stardestro/MechaMocha_ERBIE/serviceDiagram.png

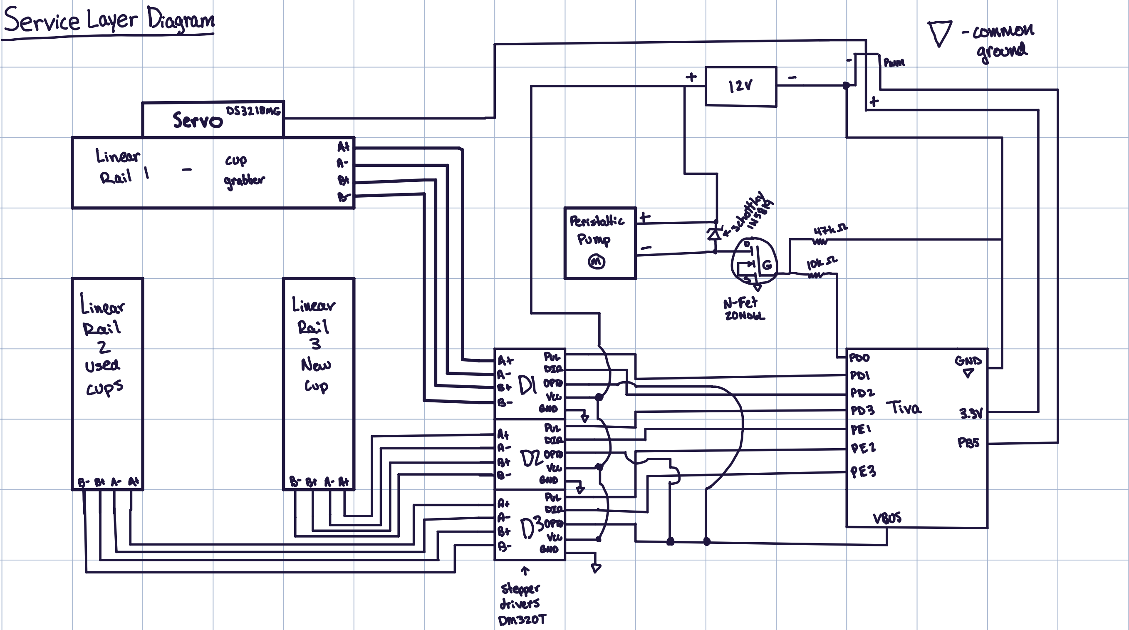
serviceDiagram.png
