stardestro/MechaMocha_ERBIE/3D Files/1802-0043-0001 assembly.stl

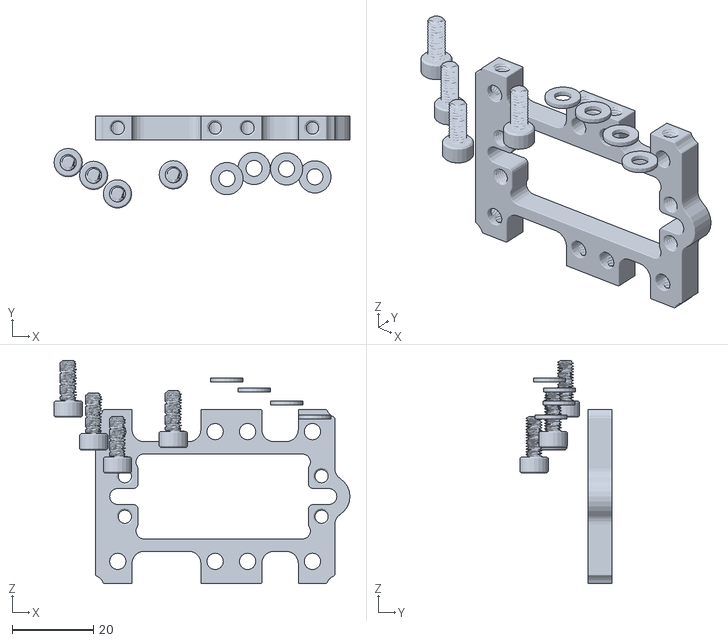
[picture p19: CAD file, 2024-05-01]
3D Files/1802-0043-0001 assembly.stl
73.0 x 22.7 x 55.1
