stardestro/MechaMocha_ERBIE/3D Files/SPOUT.stl

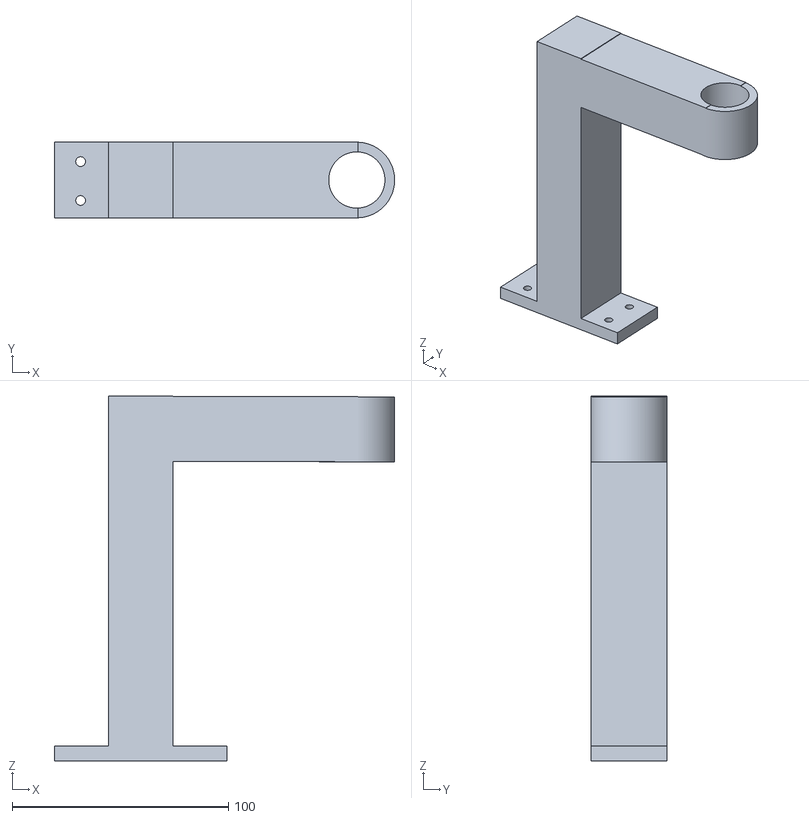
[picture p20: CAD file, 2024-05-01]
3D Files/SPOUT.stl
157.5 x 35.0 x 168.9
