stardestro/MechaMocha_ERBIE/3D Files/GearTest.stl

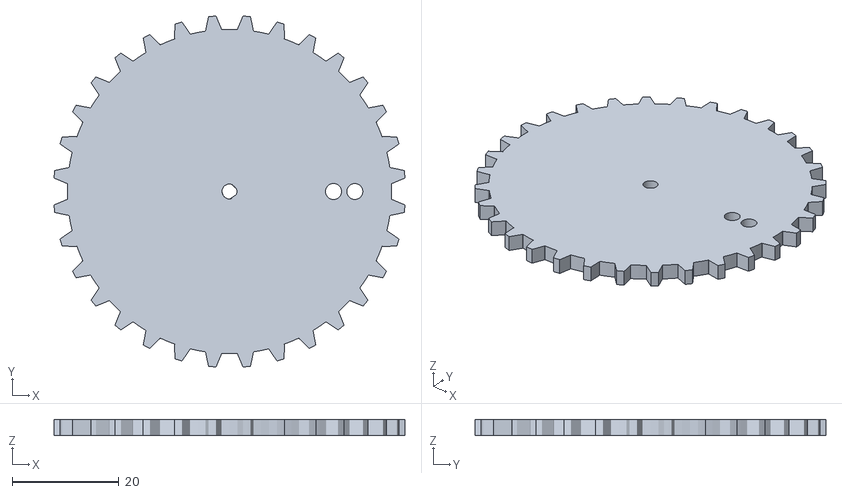
[picture p21: CAD file, 2024-05-01]
3D Files/GearTest.stl
65.8 x 65.8 x 3.00
