stardestro/MechaMocha_ERBIE/3D Files/SplineTest.stl

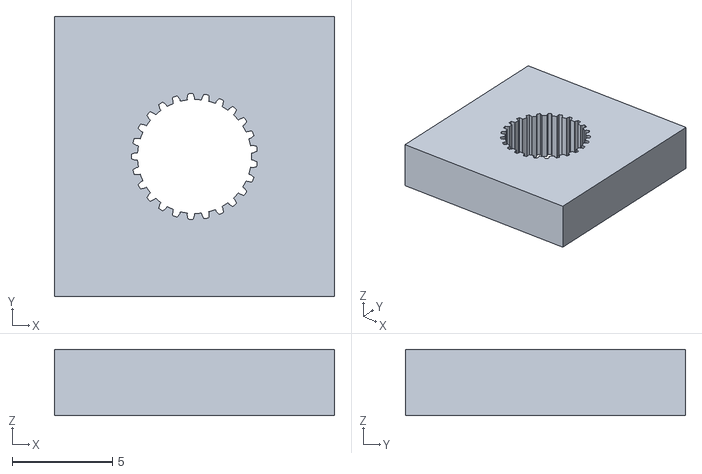
[picture p22: CAD file, 2024-05-01]
3D Files/SplineTest.stl
14.0 x 14.0 x 3.31
