stardestro/MechaMocha_ERBIE/3D Files/mountingplate.stl

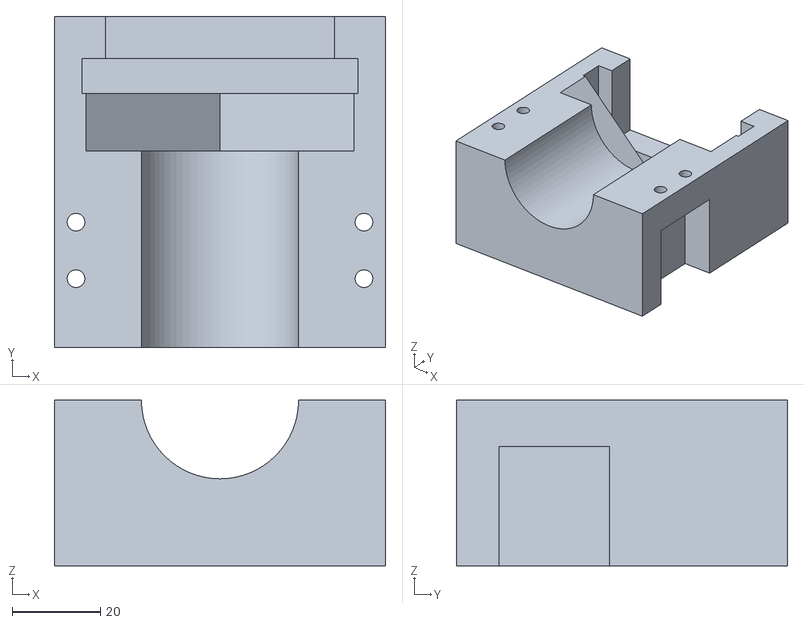
[picture p23: CAD file, 2024-05-01]
3D Files/mountingplate.stl
75.0 x 75.0 x 37.5
