stardestro/MechaMocha_ERBIE/3D Files/GrabberWithLimitSwitchV2.stl

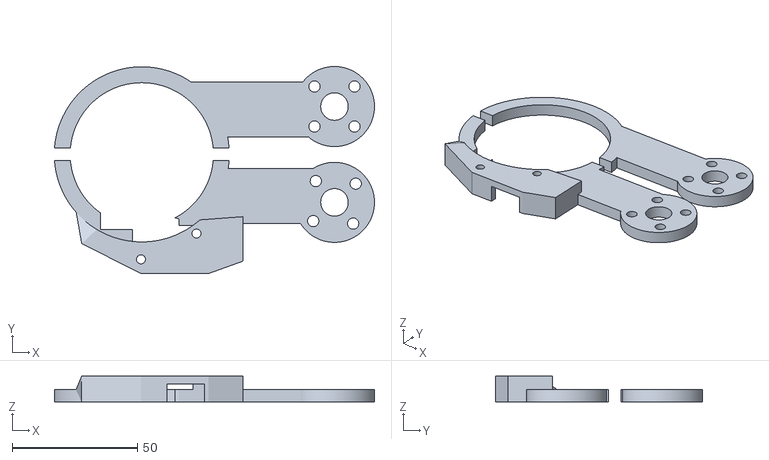
[picture p24: CAD file, 2024-05-01]
3D Files/GrabberWithLimitSwitchV2.stl
127.9 x 82.7 x 10.3
