stardestro/MechaMocha_ERBIE/3D Files/jetsonHolder.stl

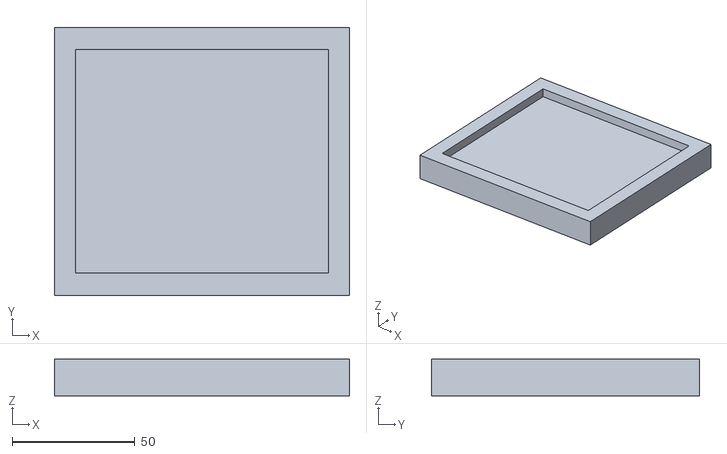
[picture p25: CAD file, 2024-05-01]
3D Files/jetsonHolder.stl
120.0 x 108.9 x 15.0
