stardestro/MechaMocha_ERBIE/3D Files/CoffeeGrabberHolderV2.stl

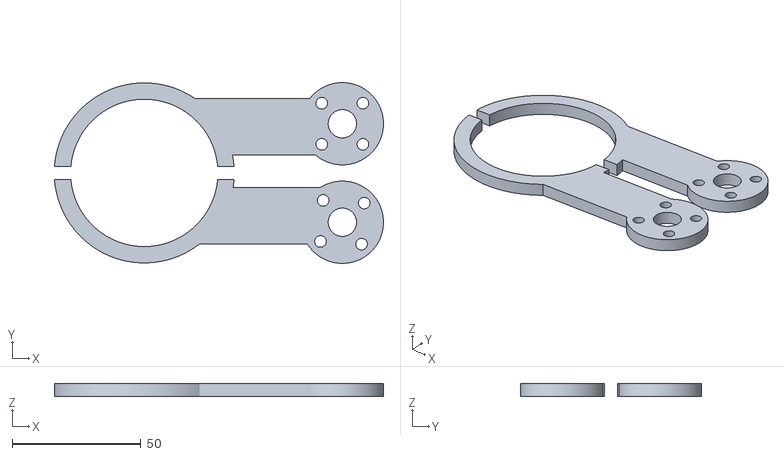
[picture p26: CAD file, 2024-05-01]
3D Files/CoffeeGrabberHolderV2.stl
127.9 x 70.3 x 5.00
