stardestro/MechaMocha_ERBIE/3D Files/SPOUTV2.stl

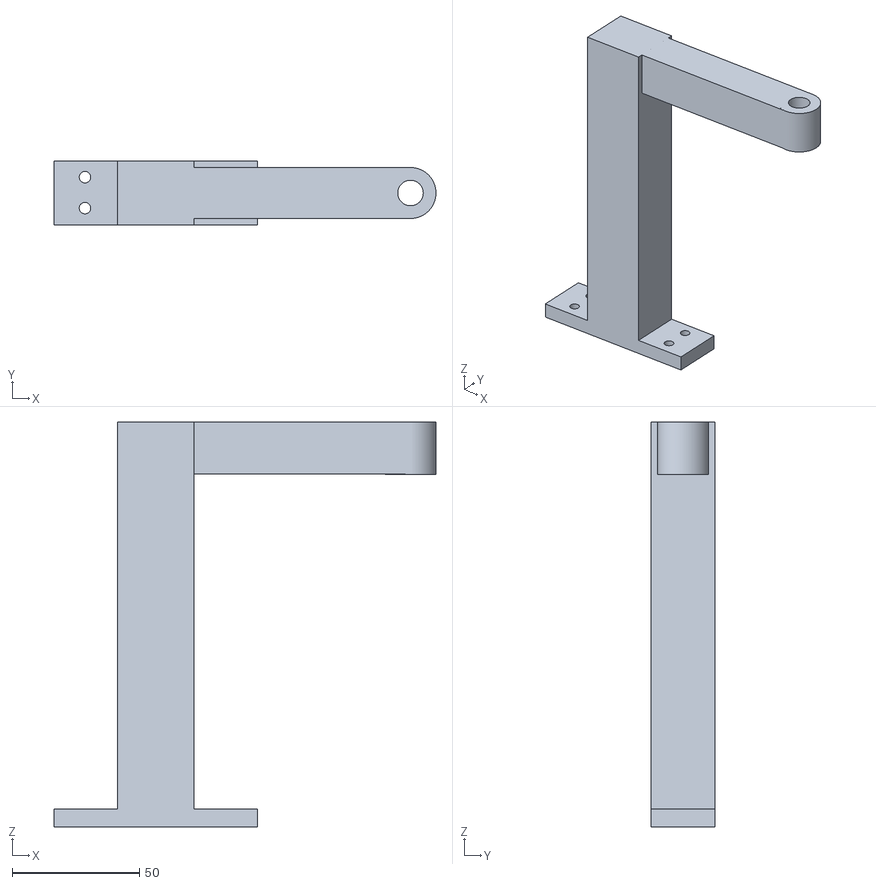
[picture p27: CAD file, 2024-05-01]
3D Files/SPOUTV2.stl
150.0 x 25.0 x 159.0
