stardestro/MechaMocha_ERBIE/3D Files/GuideRailV2.stl

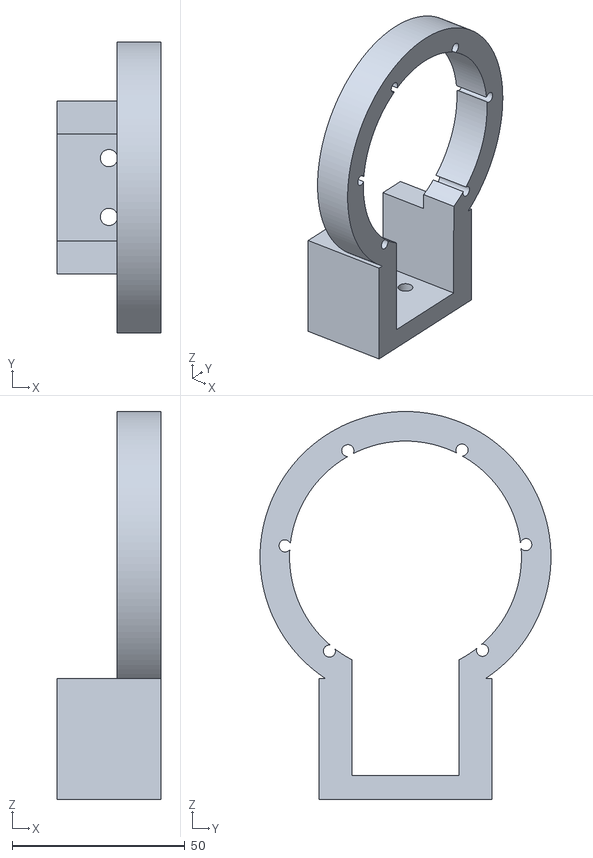
[picture p28: CAD file, 2024-05-01]
3D Files/GuideRailV2.stl
30.0 x 84.1 x 112.2
