stardestro/MechaMocha_ERBIE/3D Files/CoffeeGrabberSupportV3stl.stl

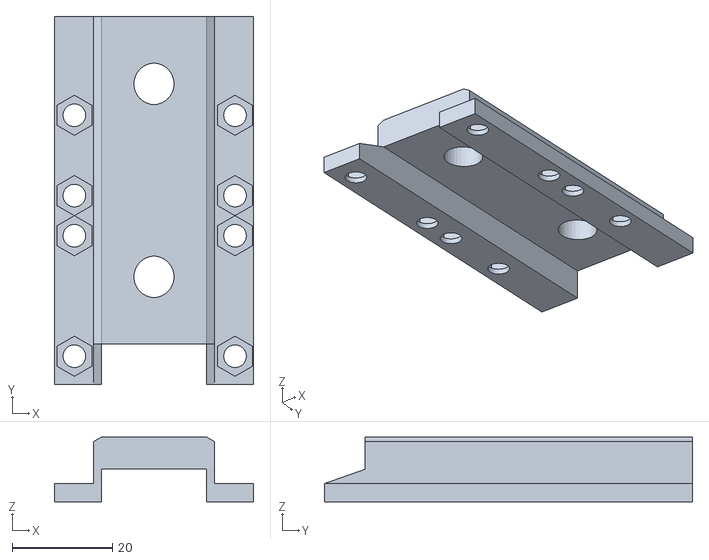
[picture p29: CAD file, 2024-05-01]
3D Files/CoffeeGrabberSupportV3stl.stl
39.7 x 73.3 x 12.9
