stardestro/MechaMocha_ERBIE/3D Files/StackHolder.stl

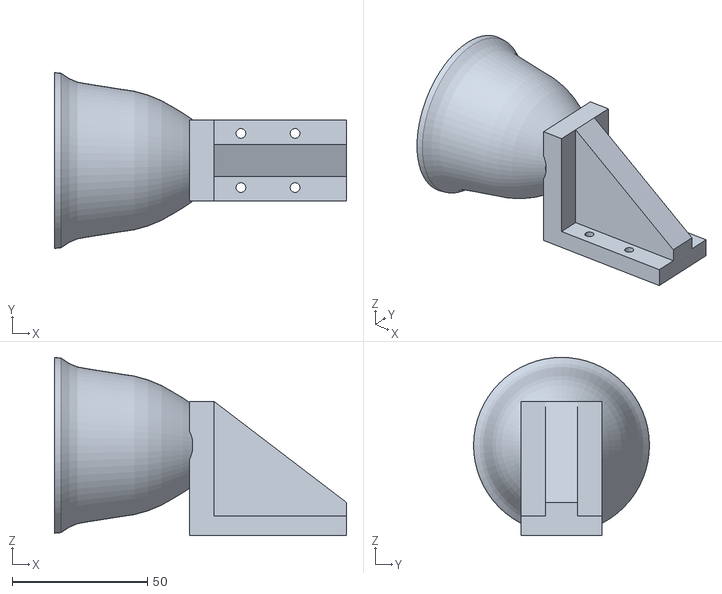
[picture p30: CAD file, 2024-05-01]
3D Files/StackHolder.stl
107.9 x 65.0 x 65.9
