stardestro/MechaMocha_ERBIE/3D Files/CupSizeExperimentV3.stl

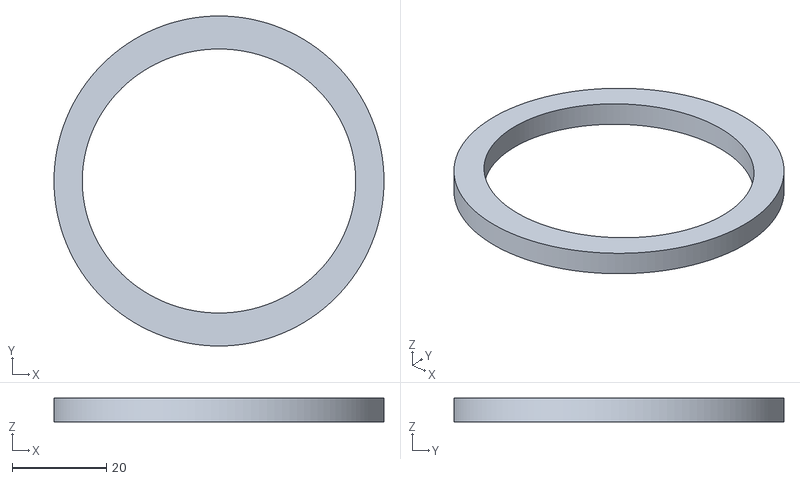
[picture p31: CAD file, 2024-05-01]
3D Files/CupSizeExperimentV3.stl
70.0 x 70.0 x 5.00
