stardestro/MechaMocha_ERBIE/3D Files/coffeearm.stl

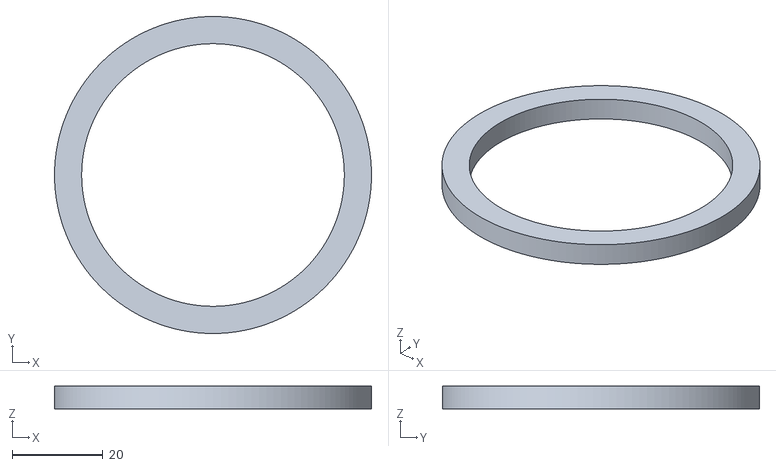
[picture p32: CAD file, 2024-05-01]
3D Files/coffeearm.stl
70.0 x 70.0 x 5.00
