stardestro/MechaMocha_ERBIE/3D Files/OverFlow.stl

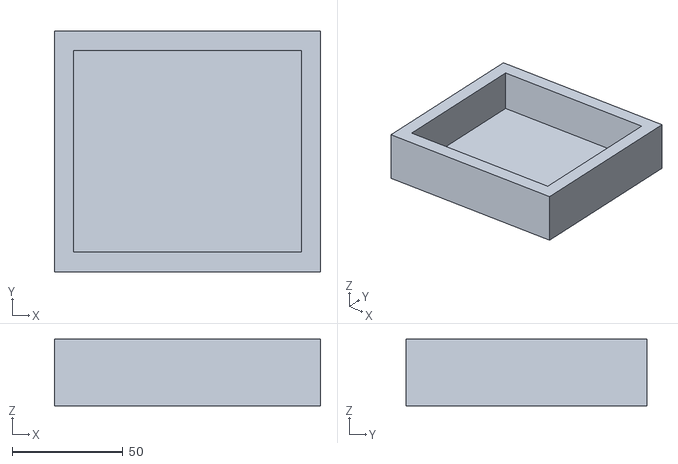
[picture p33: CAD file, 2024-05-01]
3D Files/OverFlow.stl
120.0 x 108.9 x 30.0
