stardestro/MechaMocha_ERBIE/3D Files/1910-0025-0816.stl

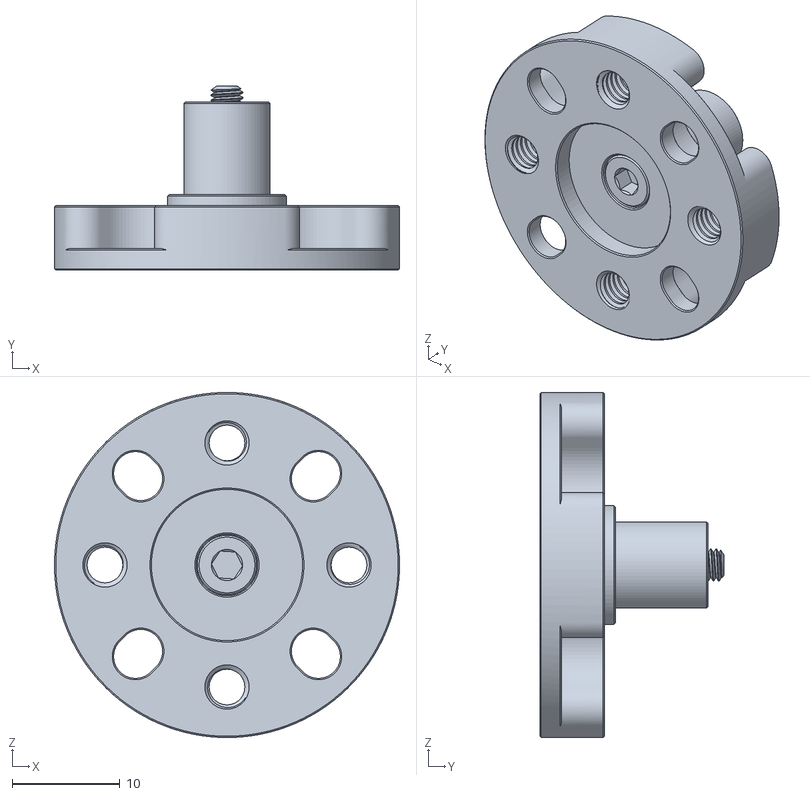
[picture p34: CAD file, 2024-05-01]
3D Files/1910-0025-0816.stl
32.0 x 17.1 x 32.0
