stardestro/MechaMocha_ERBIE/3D Files/faceplate.stl

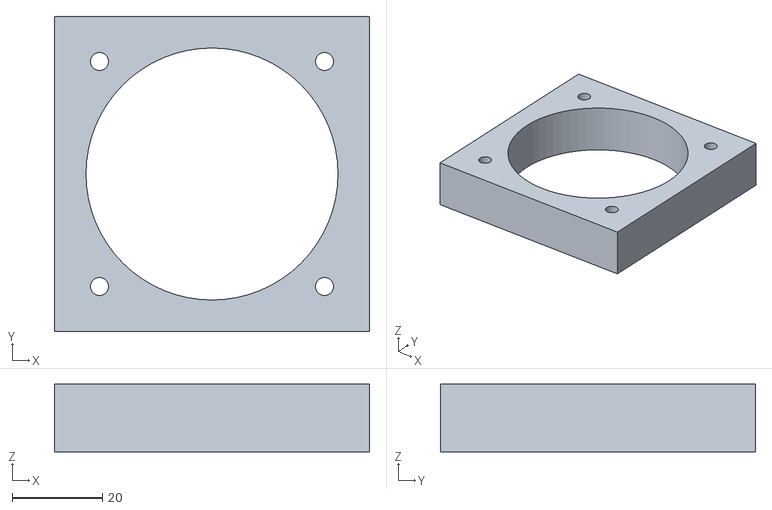
[picture p35: CAD file, 2024-05-01]
3D Files/faceplate.stl
70.0 x 70.0 x 15.0
