stardestro/MechaMocha_ERBIE/3D Files/1910-0024-1033.stl

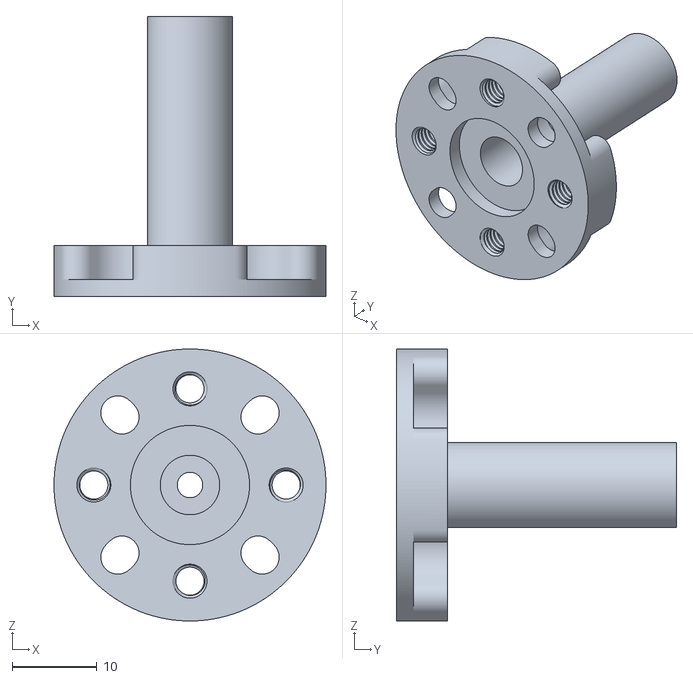
[picture p36: CAD file, 2024-05-01]
3D Files/1910-0024-1033.stl
32.0 x 33.0 x 32.0
