stardestro/MechaMocha_ERBIE/3D Files/mountingplateV2.stl

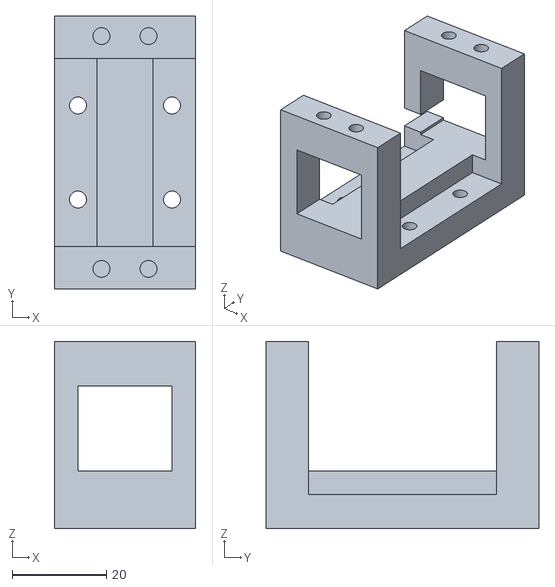
[picture p37: CAD file, 2024-05-01]
3D Files/mountingplateV2.stl
30.0 x 58.0 x 39.8
