stardestro/MechaMocha_ERBIE/3D Files/PumpholderV3.stl

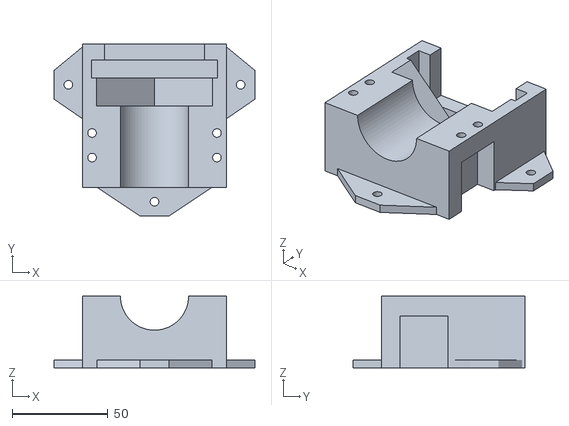
[picture p38: CAD file, 2024-05-01]
3D Files/PumpholderV3.stl
105.0 x 90.0 x 37.5
