stardestro/MechaMocha_ERBIE/3D Files/realsenseholder.stl

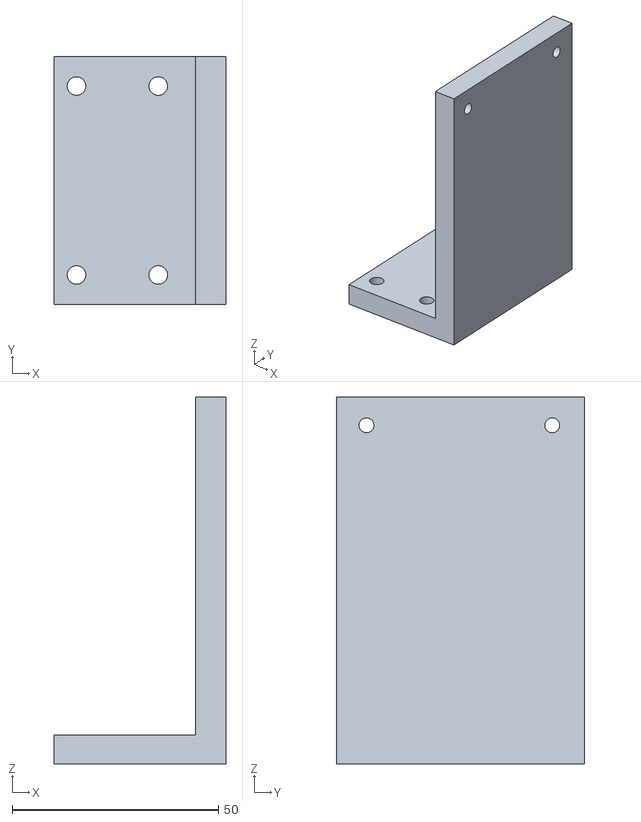
[picture p39: CAD file, 2024-05-01]
3D Files/realsenseholder.stl
41.6 x 60.0 x 88.9
