stardestro/MechaMocha_ERBIE/3D Files/GrabberWithLimitSwitch.stl

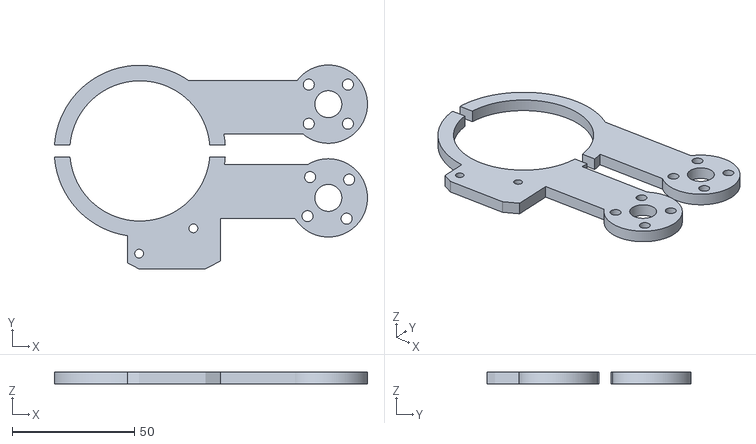
[picture p40: CAD file, 2024-05-01]
3D Files/GrabberWithLimitSwitch.stl
127.9 x 83.4 x 5.00
