stardestro/MechaMocha_ERBIE/3D Files/realsensetest.stl

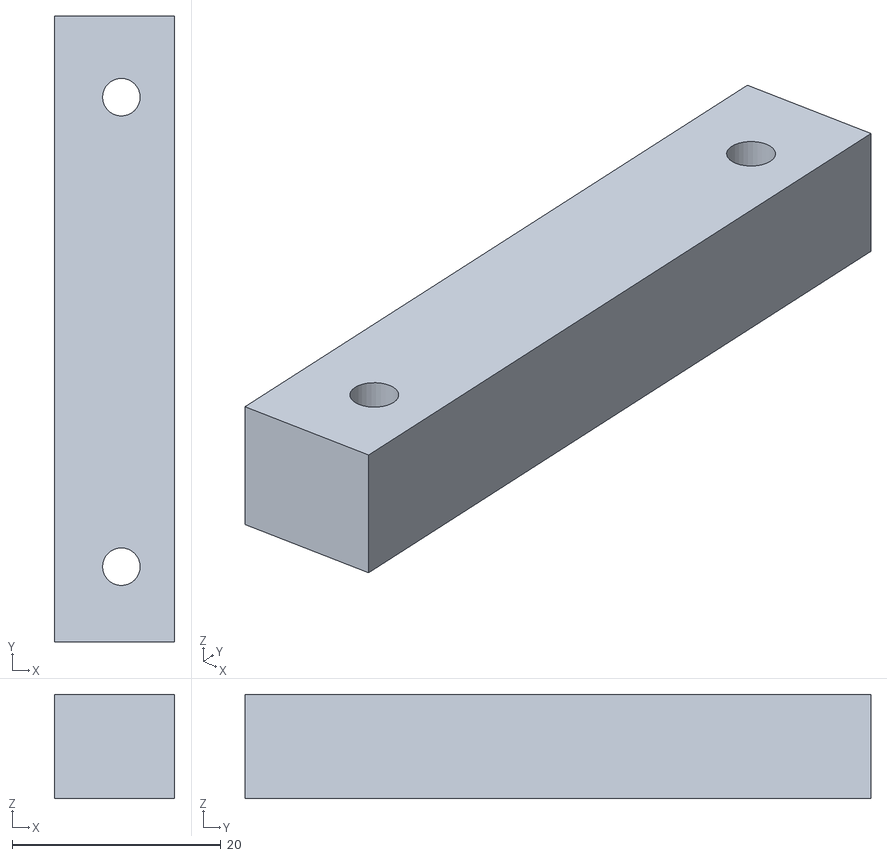
[picture p41: CAD file, 2024-05-01]
3D Files/realsensetest.stl
11.5 x 60.0 x 10.0
