stardestro/MechaMocha_ERBIE/3D Files/qahwacupwithhole.stl

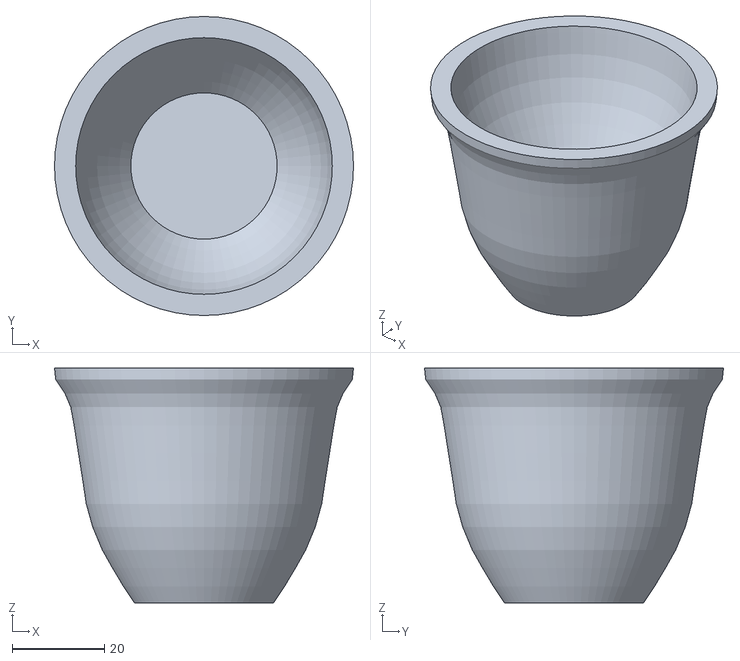
[picture p43: CAD file, 2024-05-01]
3D Files/qahwacupwithhole.stl
65.0 x 65.0 x 51.0
