stardestro/MechaMocha_ERBIE/3D Files/2302-0014-0048.stl

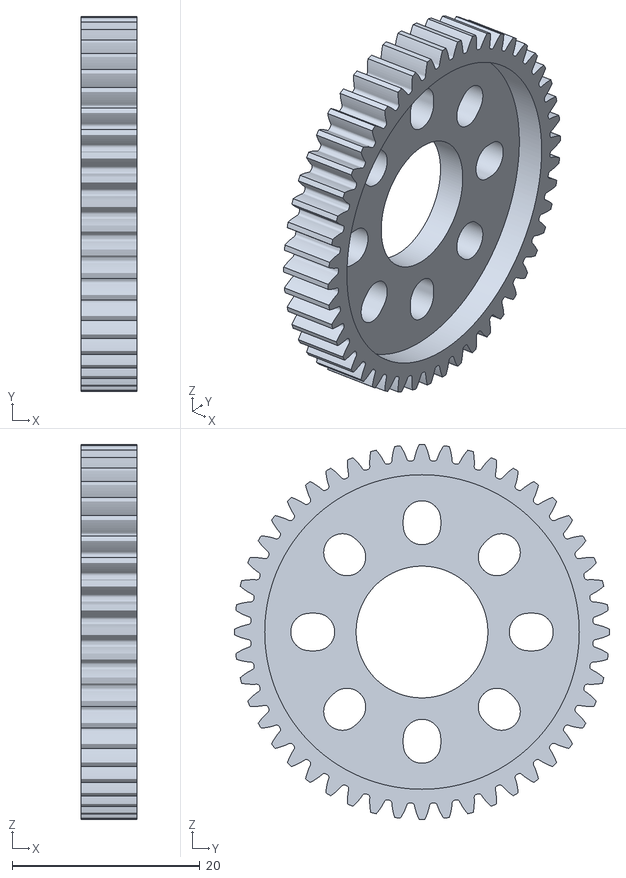
[picture p44: CAD file, 2024-05-01]
3D Files/2302-0014-0048.stl
6.00 x 40.0 x 40.0
