stardestro/MechaMocha_ERBIE/3D Files/PumpholderH2.stl

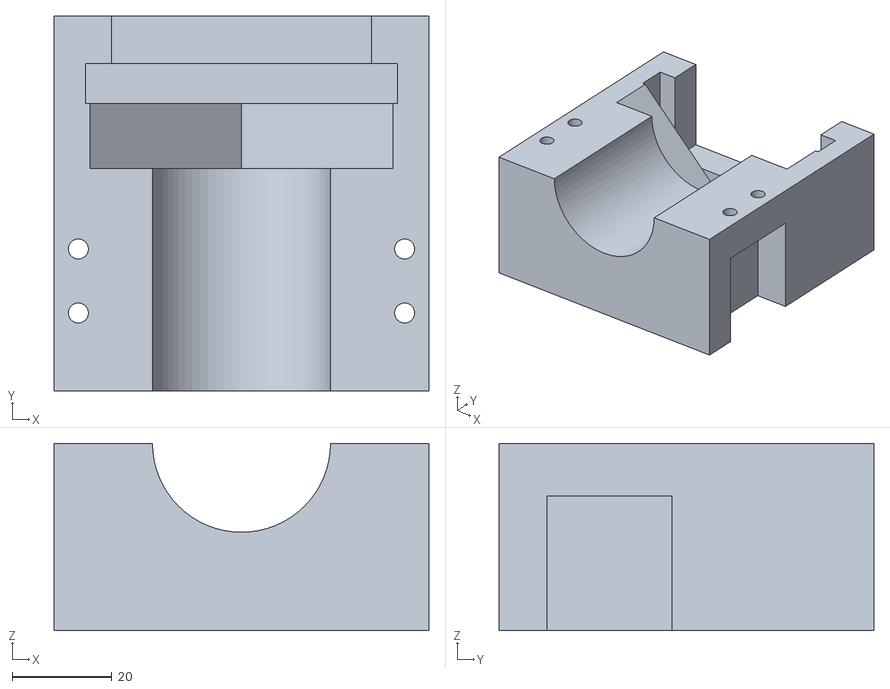
[picture p45: CAD file, 2024-05-01]
3D Files/PumpholderH2.stl
75.0 x 75.0 x 37.5
