stardestro/MechaMocha_ERBIE/3D Files/CupholderV2.stl

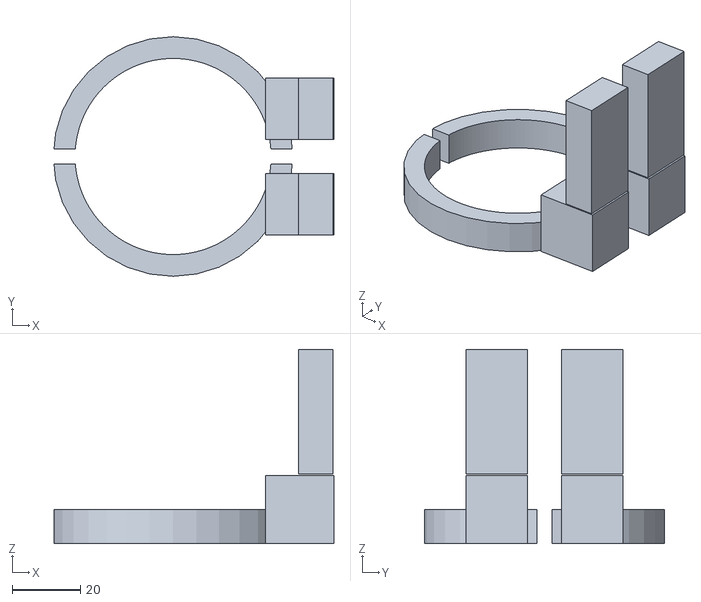
[picture p46: CAD file, 2024-05-01]
3D Files/CupholderV2.stl
81.8 x 70.0 x 56.8
