stardestro/MechaMocha_ERBIE/3D Files/stackerbase.stl

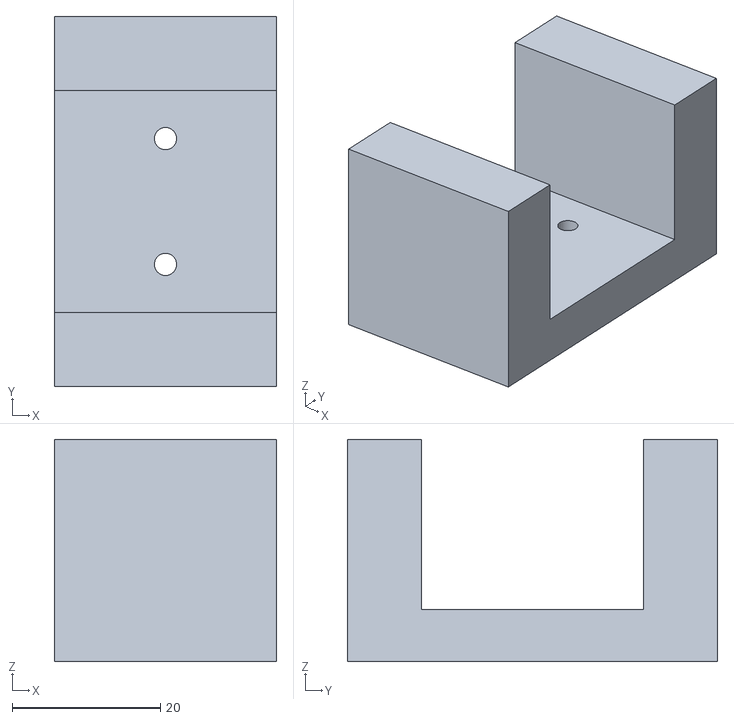
[picture p47: CAD file, 2024-05-01]
3D Files/stackerbase.stl
30.0 x 50.0 x 30.0
