stardestro/MechaMocha_ERBIE/3D Files/baseconnectorV2stl.stl

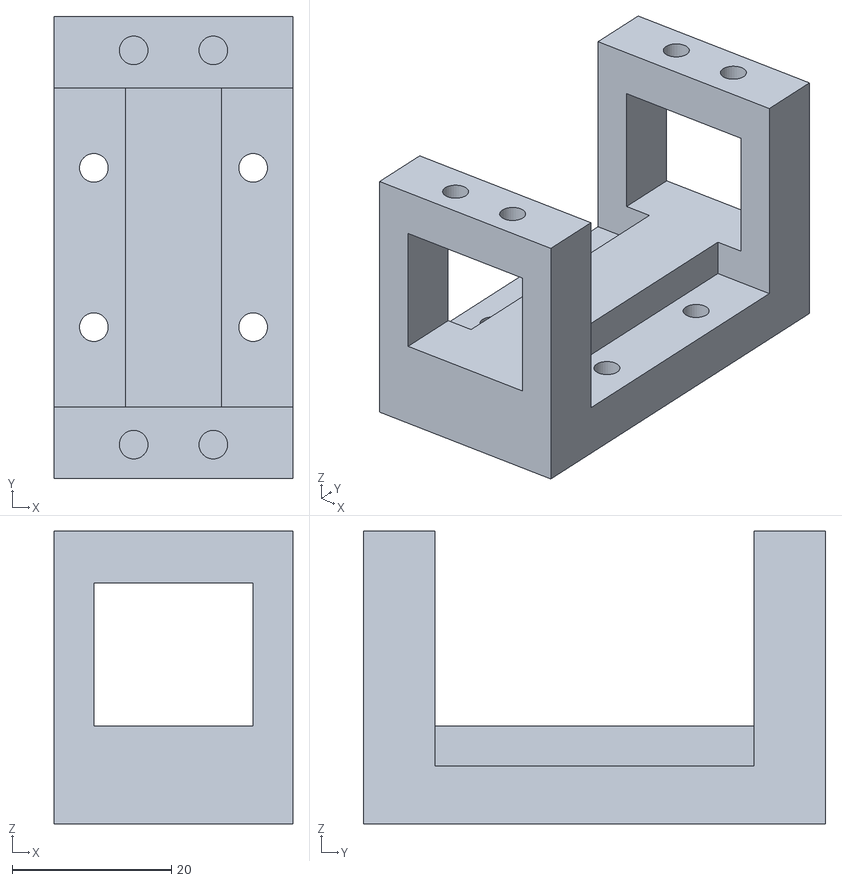
[picture p48: CAD file, 2024-05-01]
3D Files/baseconnectorV2stl.stl
30.0 x 58.0 x 36.8
