stardestro/MechaMocha_ERBIE/3D Files/CoffeeGrabberSupportV5.stl

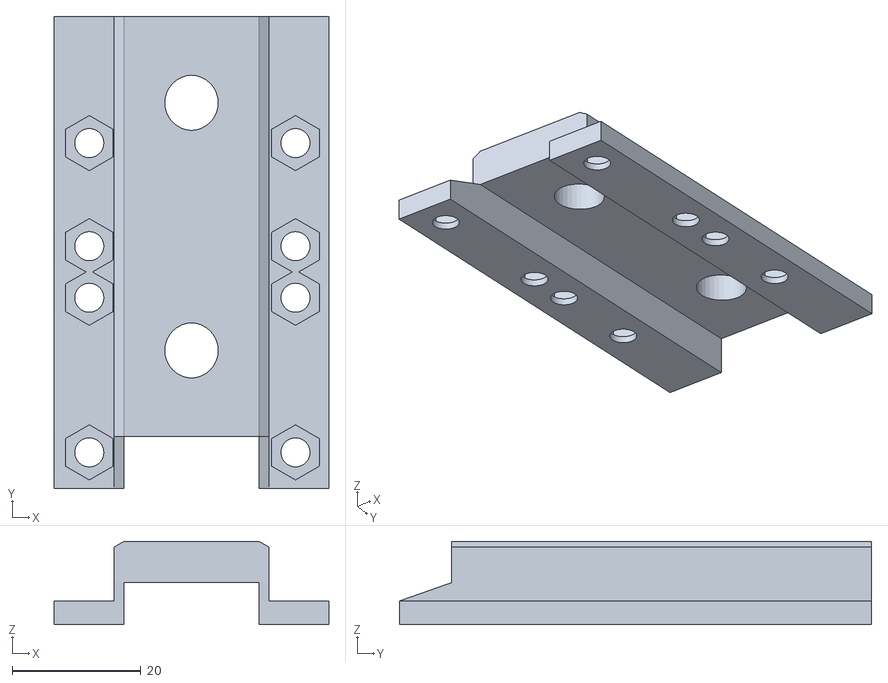
[picture p49: CAD file, 2024-05-01]
3D Files/CoffeeGrabberSupportV5.stl
42.7 x 73.3 x 12.9
