stardestro/MechaMocha_ERBIE/3D Files/CoffeeStackerFinalV1.stl

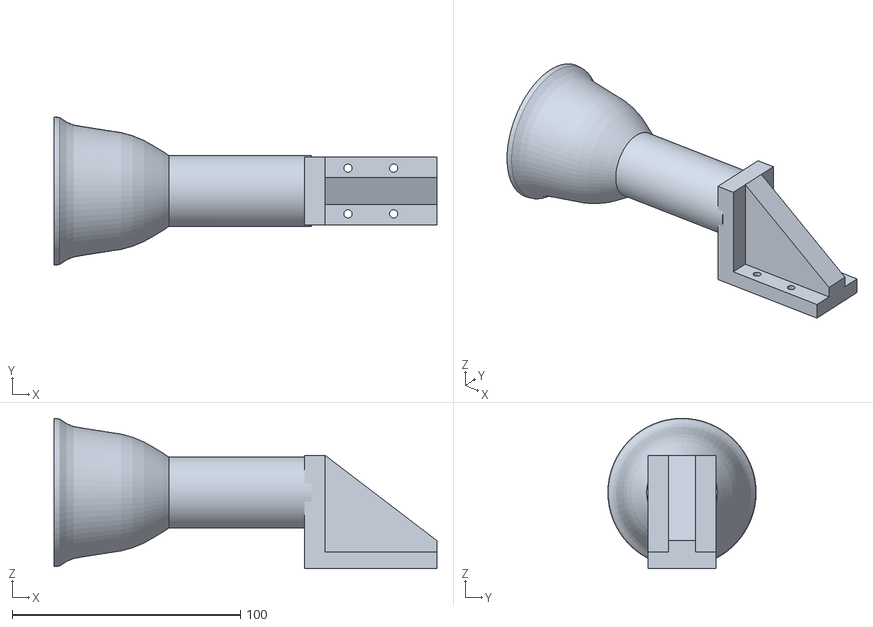
[picture p50: CAD file, 2024-05-01]
3D Files/CoffeeStackerFinalV1.stl
167.9 x 65.0 x 65.9
