stardestro/MechaMocha_ERBIE/3D Files/baseconnectorV3.stl

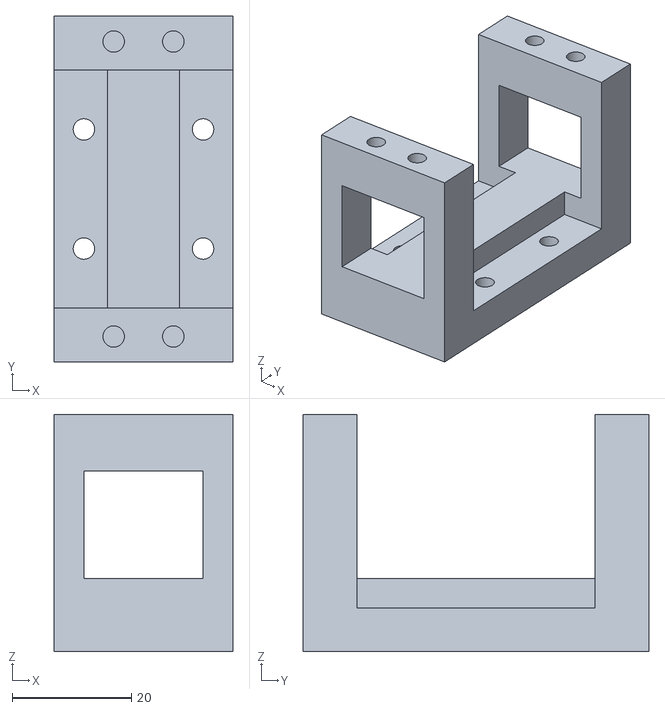
[picture p51: CAD file, 2024-05-01]
3D Files/baseconnectorV3.stl
30.0 x 58.0 x 39.8
