stardestro/MechaMocha_ERBIE/3D Files/CoffeGrabberSupportV2.stl

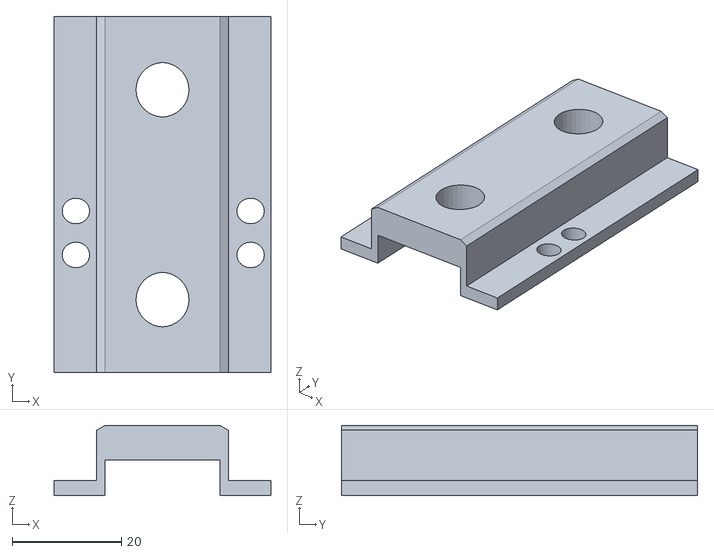
[picture p52: CAD file, 2024-05-01]
3D Files/CoffeGrabberSupportV2.stl
39.7 x 65.2 x 12.9
