stardestro/MechaMocha_ERBIE/3D Files/ServoHolderV2.stl

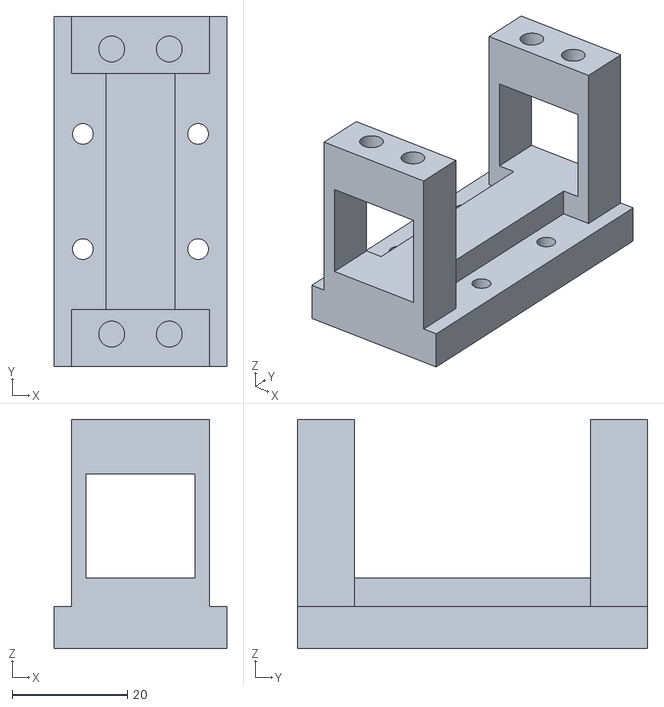
[picture p53: CAD file, 2024-05-01]
3D Files/ServoHolderV2.stl
30.0 x 60.8 x 39.8
