stardestro/MechaMocha_ERBIE/3D Files/baseconnector.stl

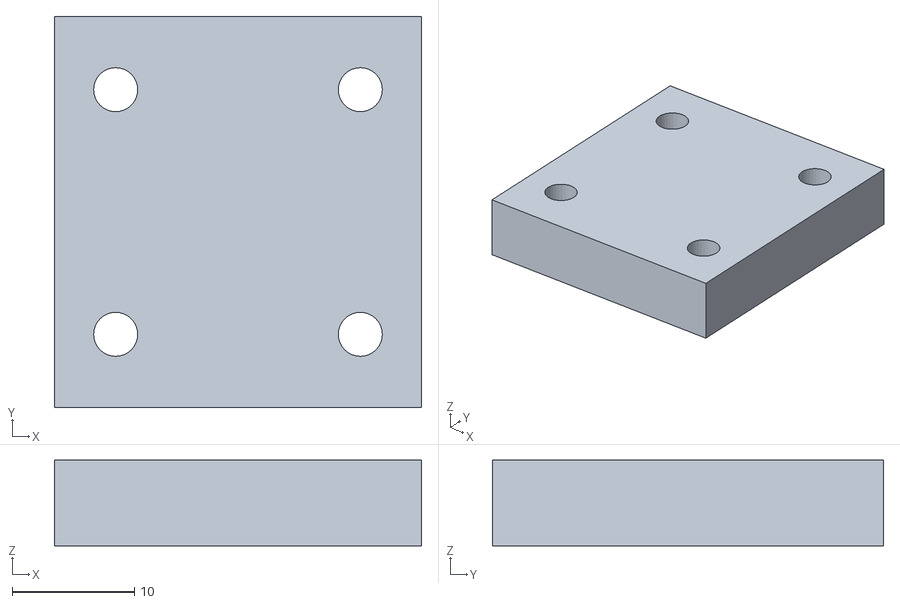
[picture p54: CAD file, 2024-05-01]
3D Files/baseconnector.stl
30.0 x 32.0 x 7.00
