stardestro/MechaMocha_ERBIE/3D Files/qahwacup.stl

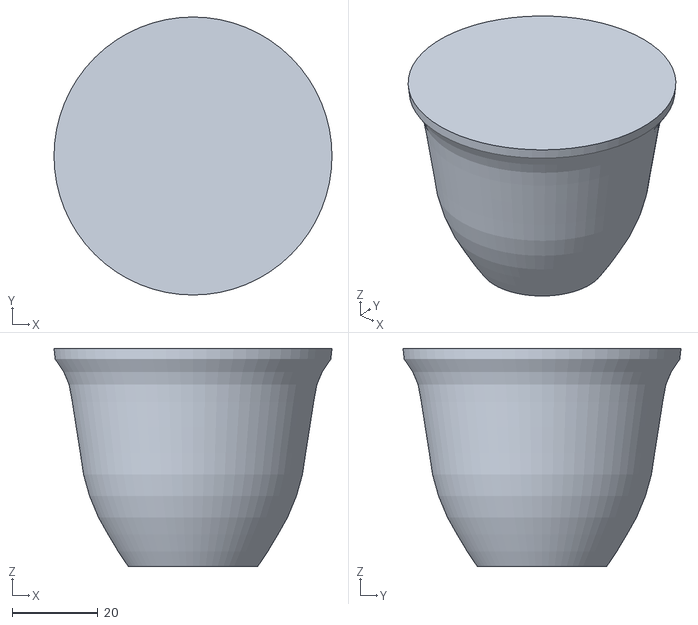
[picture p55: CAD file, 2024-05-01]
3D Files/qahwacup.stl
65.0 x 65.0 x 51.0
