stardestro/MechaMocha_ERBIE/3D Files/ServoHolderReinforced.stl

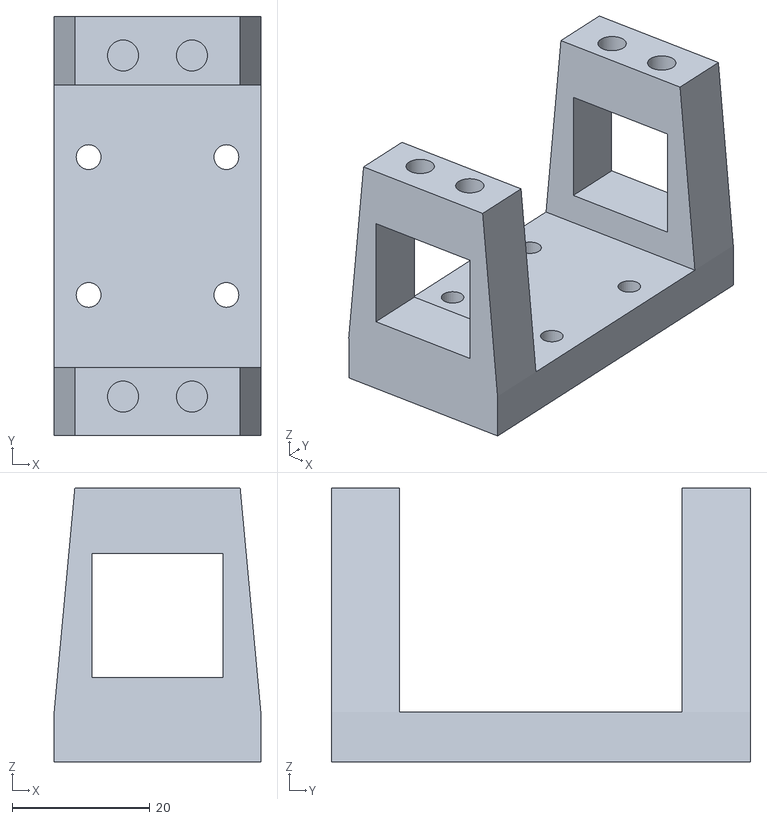
[picture p56: CAD file, 2024-05-01]
3D Files/ServoHolderReinforced.stl
30.0 x 60.8 x 39.8
