stardestro/MechaMocha_ERBIE/(list of files, cad)

Other CAD files:
3D Files/CoffeeGrabberV1.stl
3D Files/GuideRail.stl
3D Files/ServoHolderReinforcedV2.stl
3D Files/CupGrabberHolderV3.stl
3D Files/CoffeeGrabberHolderV1.stl
3D Files/CoffeeGrabberSupportV1.stl
3D Files/CoffeeGrabberSupportV3.stl
3D Files/CoffeeGrabberSupportV4.stl
3D Files/CupSizeExperimentV1.stl
3D Files/CupholderV1.stl
3D Files/PumpholderV2.stl
3D Files/jetsonholder.stl
