stardestro/MechaMocha_ERBIE/mobile_layer_schematic.pdf

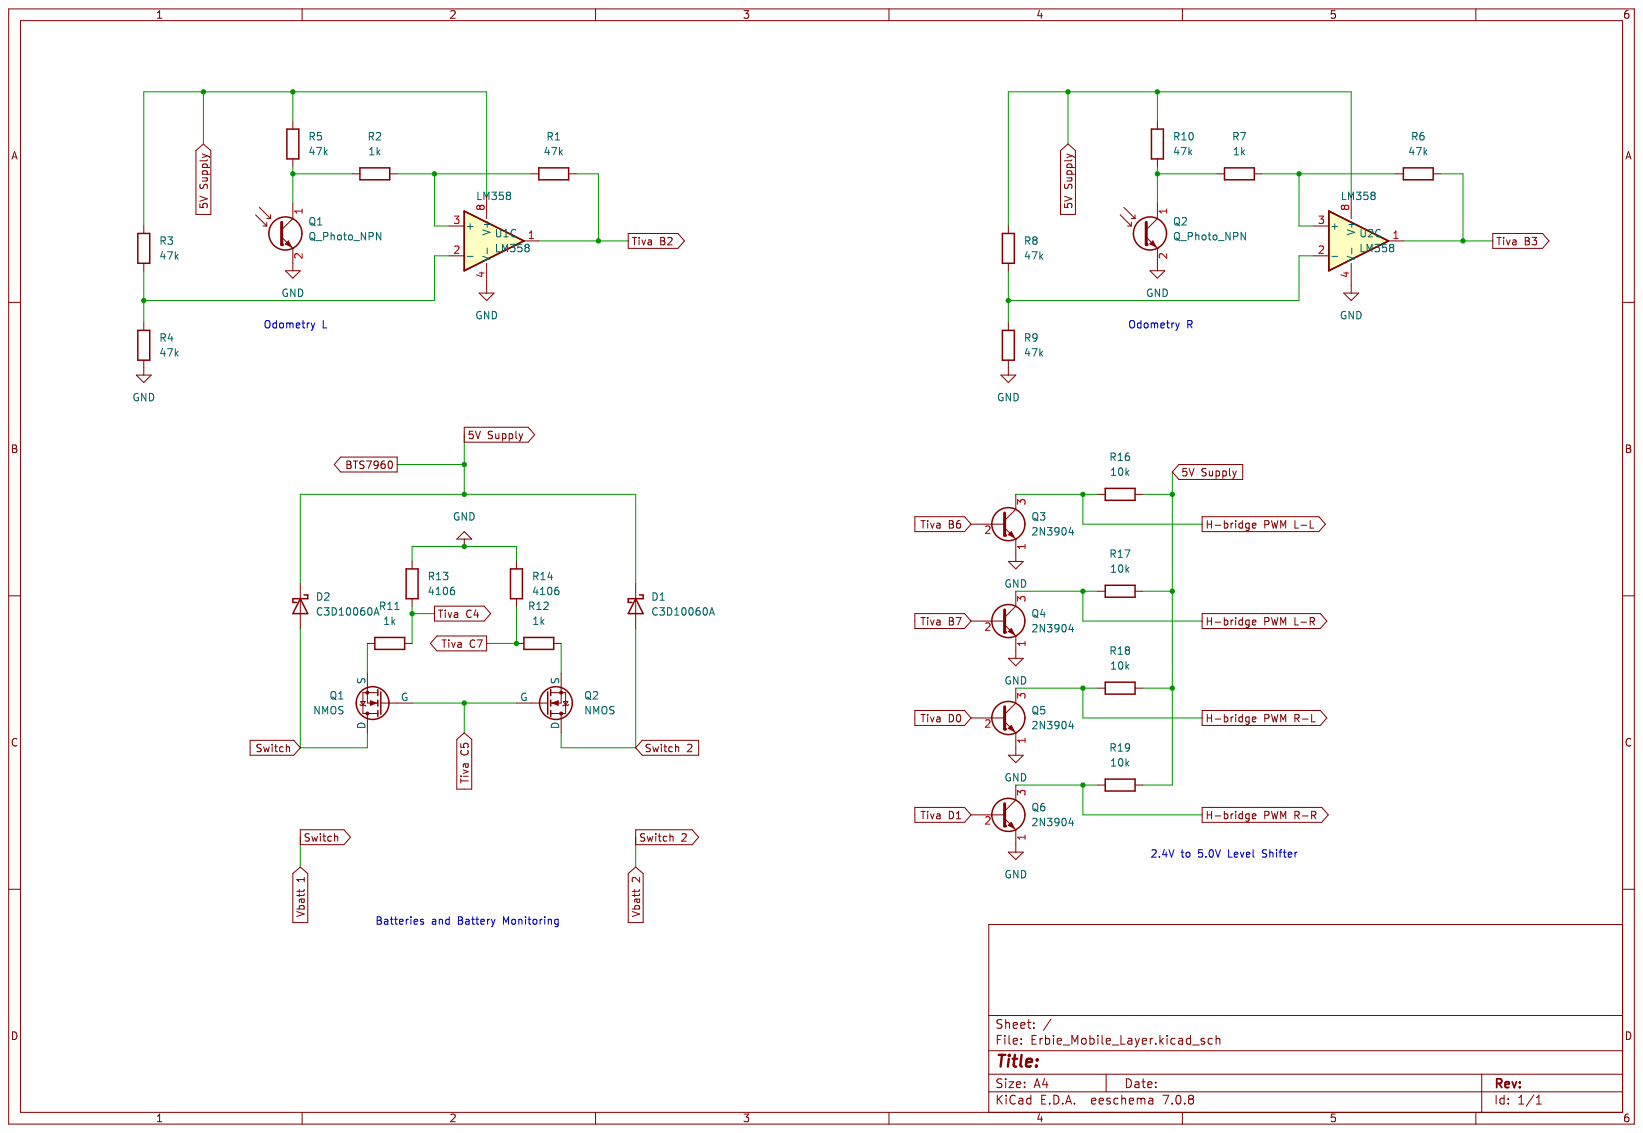
[picture p57: page 1]
