stardestro/MechaMocha_ERBIE/Erbie_Mobile_Layer.kicad_sch

## KiCad design Erbie_Mobile_Layer.kicad_sch (2024-05-04)

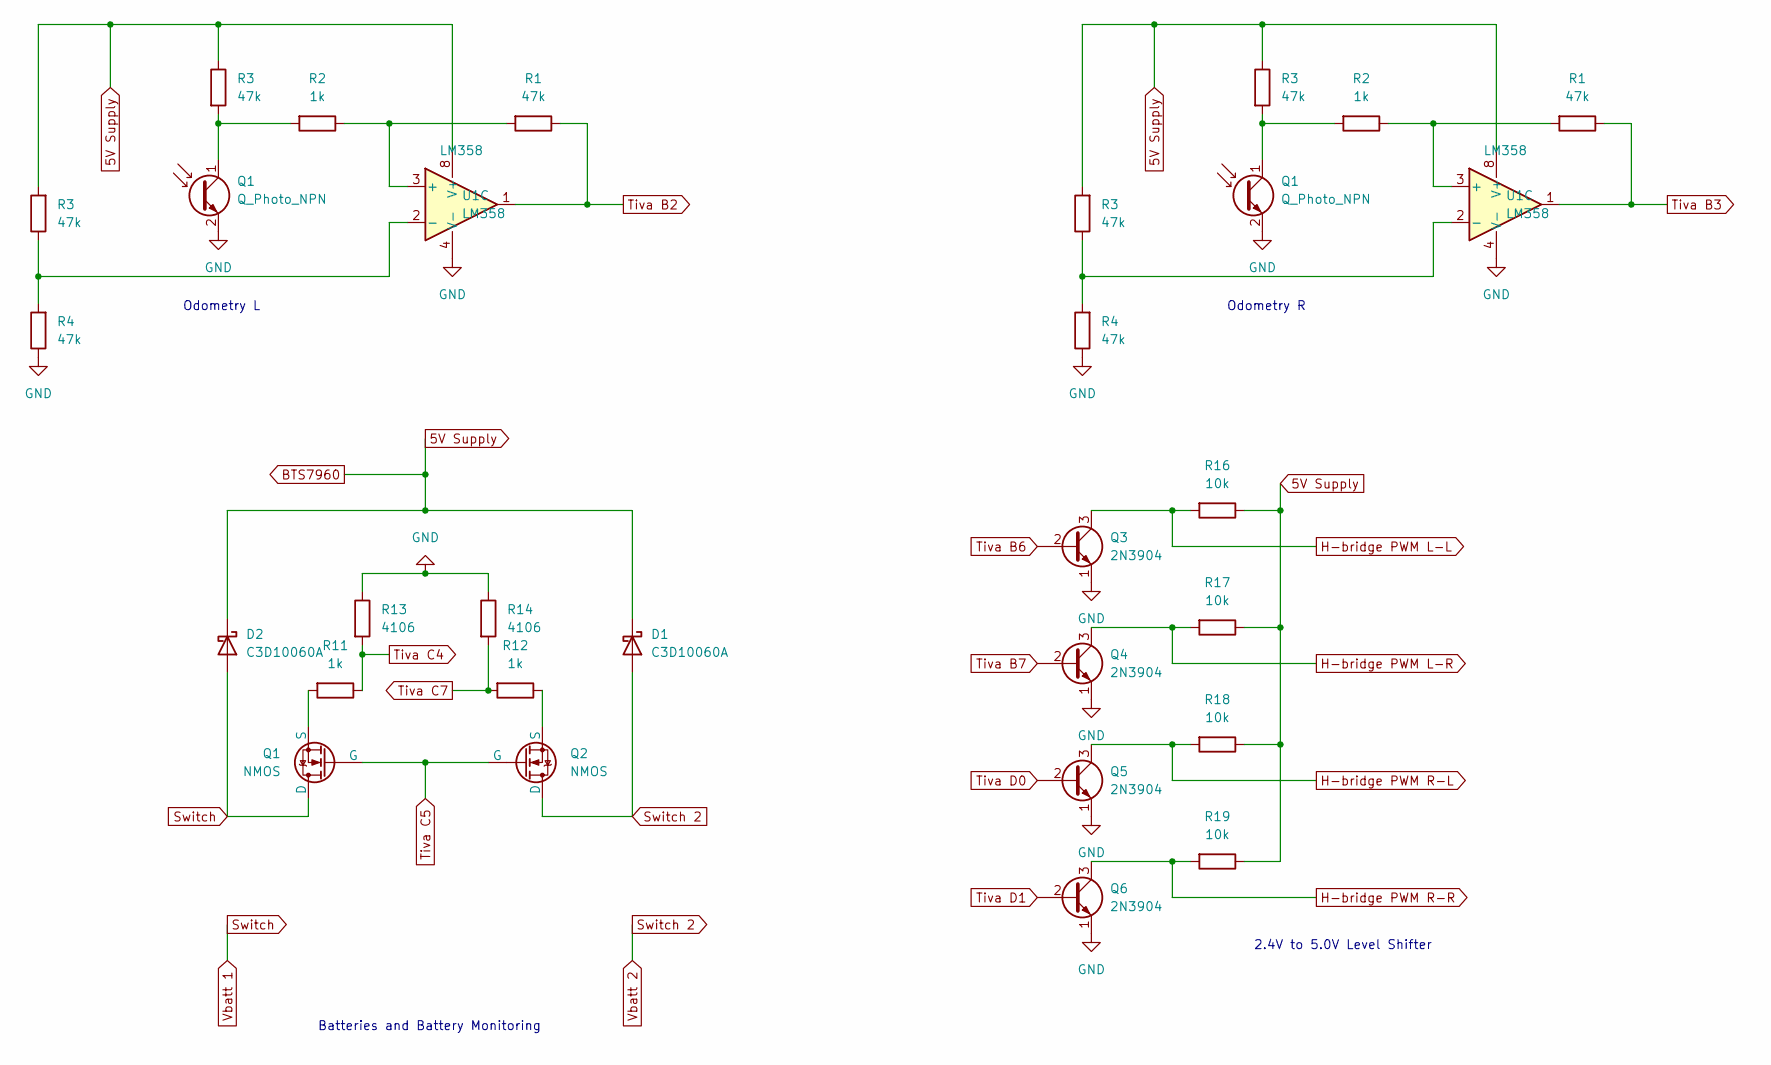
[picture p58: schematic Erbie_Mobile_Layer.kicad_sch]

Parts:
D1, D2: C3D10060A; TO-220-2_Vertical
Q1: Q_Photo_NPN
Q2: NMOS
Q3, Q4, Q5, Q6: 2N3904; TO-92_Inline
R1, R3, R4: 47k
R2, R11, R12: 1k
R13, R14: 4106
R16, R17, R18, R19: 10k
U1: LM358

Connections:
5V Supply: D1.1 (K), D2.1 (K), R3.1, R3.2, R16.1, R17.1, R18.1, R19.1, U1.8 (V+)
GND: Q1.2 (G), Q3.1 (E), Q4.1 (E), Q5.1 (E), Q6.1 (E), R4.1, R13.1, R14.1, U1.4 (V-)
H-bridge PWM L-L: Q3.3 (C), R16.2
H-bridge PWM L-R: Q4.3 (C), R17.2
H-bridge PWM R-L: Q5.3 (C), R18.2
H-bridge PWM R-R: Q6.3 (C), R19.2
unnamed: Q1.1 (D), R2.2, R3.2
unnamed: Q1.3 (S), R11.2
unnamed: Q2.3 (S), R12.1
unnamed: R1.2, R2.1, U1.3 (+)
unnamed: R3.1, R4.2, U1.2 (-)
Switch: D2.2 (A), Q1.1 (D)
Switch 2: D1.2 (A), Q2.1 (D)
Tiva B2: R1.1, U1.1
Tiva B3: R1.1, U1.1
Tiva B6: Q3.2 (B)
Tiva B7: Q4.2 (B)
Tiva C4: R11.1, R13.2
Tiva C5: Q1.2 (G), Q2.2 (G)
Tiva C7: R12.2, R14.2
Tiva D0: Q5.2 (B)
Tiva D1: Q6.2 (B)

Notes on the sheet:
Odometry L
2.4V to 5.0V Level Shifter
Batteries and Battery Monitoring
Odometry R
