stardestro/MechaMocha_ERBIE/(commit log)

2024-05-01 Placed all 3D files in their own folder
    [1802-0043-0001 assembly.stl, 1910-0024-1033.stl, 1910-0025-0816.stl, 2302-0014-0048.stl, CoffeGrabberSupportV2.stl, CoffeeGrabberHolderV1.stl, CoffeeGrabberHolderV2.stl, CoffeeGrabberSupportV1.stl]
2024-05-04 Uploaded Chris Dewitt Files
    [Erbie_Mobile_Layer.kicad_sch, Erbie_Parts_List.csv]
